PropTroniX/E-11-Blaster-Scope-Electronics-V1.0/README.md

------------

##### *Table of Contents*
- [Arduino E-11 Animated Blaster Scope](#arduino-e-11-animated-blaster-scope)
- [Video of the Prototype](#video-of-the-prototype)
- [Parts Required](#parts-required)
- [Software Required](#software-required)
- [Wiring Schematics](#wiring-schematics)
- [Programming Instructions](#programming-instructions)
- [3D Print STL Files](#3d-print-stl-files)
- [Licence](#licence)
- [Donation Button](#donation-button)

### Arduino E-11 Animated Blaster Scope

Arduino code and STL files for an animated Star Wars E-11 Blaster Scope with optional Red Dot Laser Sight. 
This is a very basic build just to add some functionality to your Star Wars Blaster Scope.
Easy to build with only minimal wiring required using cheap and readily available parts. 
The 3D STL files to print the E-11 Blaster Scope to fit these electronics are included in the Download.

If you looking for changeable Screen Displays on your Scope check out my - [E-11 V2.0 Scope Kit](https://proptronix.co.uk/prop-electronics/e-11-v2-scope-add-on-kit "PropTroniX")





### Video of the Prototype

Check out my Video of a 3D Printed Prototype with the Electronics Installed

YouTube Video - [Star Wars E-11 Blaster Scope with Electronics](https://youtu.be/OtV69T4YZjw "Star Wars E-11 Blaster Scope with Electronics")

###  Parts Required

1 x Set of 3D STLFiles  - For 3D Printing the E-11 Blaster Scope (Included FREE in the Download)

1 x [DFRobot Beetle] - ATmega32u4 V 16MHz Micro USB 

1 x [Red Laser Dot Diode] - 650nm 6mm 3V-5V (Optional)

1 x[ 0.49 OLED Display] - White OLED Screen Module SSD1306 Drive IC 64 x 32 IIC Interface

1 x [6mm Tactile Momentary Switch] - 2 Pin SPDT Momentary Tactile Pushbutton Switch 6mm x 6mm x 5mm (Optional)

1 x [10K Ω Resistor ]- 1/4W 5% Carbon Resistors - Used on the ON/Button for the Red Dot Laser

1 x [4-Pin Micro JST Cable] - (Male & female) For Connecting OLED Screen to DFRobot Beetle

1 x [3-Pin Micro JST Cable] - (Male & female) For Connecting Red Dot Laser Switch to DFRobot Beetle

2 x [2-Pin Micro JST Cable]( - (Male & female) For Connecting Red Dot Laser Diode to DFRobot Beetle & to supply 5V Power to the DFRobot Beetle

3 x [M2 Slotted Cheese Head Machine Screws] - For the Front of the Scope

2 x [4x3mm Neodymium Magnets]( - To Hold the Screen Holder in Place inside the Scope

1 x [30mm Round Glass Cabochon ]- Used as a Magnifier Lens for the Scope Eye Piece

All parts listed above are available from my Online Shop , eBay, Amazon or AliExpress.

###  Software Required

You will need the following Software & Libraries to install and setup the Scope Arduino Code on the DFRobot Beetle.
- The latest version of Arduino IDE - [Download from the Arduino Site](https://www.arduino.cc/en/Main/Software "Download from the Arduino Site")

Arduino Libraries Needed:

- WIRE - Pre-Installed with Arduino IDE
- SPI - Pre-Installed with Arduino IDE
- Adafruit GFX - Included in the Download
- Adafruit SSD1306 - Included in the download and Pre-Set for 64x32 OLED Display

SCTroniX V1.0 Arduino E-11 Scope Code:

- Arduino_Blaster_Scope-V1.0.ino - Included in the Download

###  Wiring Schematics



###  Programming Instructions

1. Copy the Two Included Libraries (Adafruit_GFX_Library & Adafruit_SSD1306-master_64x32) into your Arduino Libraries Folder.

2. Run the Arduino IDE Application

3. File Open and locate the Arduino-Blaster-Scope-V1.0 Directory and open the Load the Arduino_Blaster_Scope-V1.0.ino file.

4. Select Tools: Board: and Arduino Leonardo

5. Select Tools: Port: and Select the COM Port your DFRobot Beetle board is plugged in to.

6. Select Tools: Programmer: and choose AVRISP mkII.

7. Upload the Arduino_Blaster_Scope-V1.0.ino code to the board

You should now have a functioning Blaster Scope

### 3D Print STL Files
The download also includes a set of E-11 Blaster Scope 3D Printable STL Files. These are modified from the Free Files that are available from [My Mini Factory](https://www.myminifactory.com/object/3d-print-star-wars-storm-trooper-blastech-e-11-blaster-rifle-by-blaster-master-72283 "My Mini Factory") by Raymond Hebert.



###  Licence

This work is licensed under the Creative Commons Attribution-NonCommercial-ShareAlike 4.0 International License.
To view a copy of this license, visit https://creativecommons.org/licenses/by-nc/4.0/

### Donation Button
 Please feel free to donate a cup of coffee if you find this code useful. Thank You
