PropTroniX/E-11-Blaster-Scope-Electronics-V1.0/Scope-STL-Files/Part_#6_Scope_Lens Cap.stl

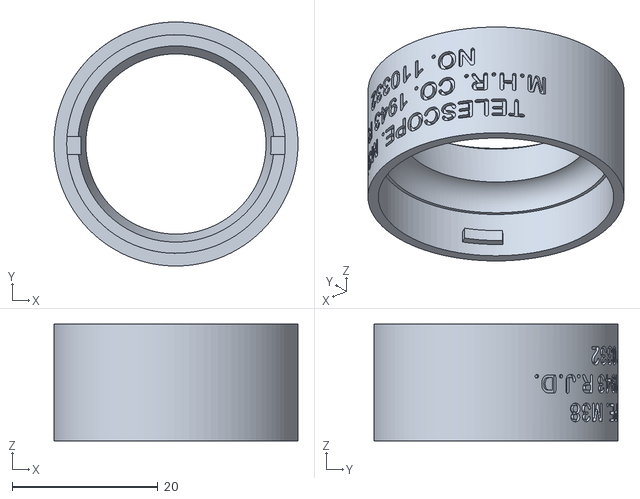
[picture p1: CAD file, 2023-04-13]
Scope-STL-Files/Part_#6_Scope_Lens Cap.stl
33.5 x 33.5 x 16.0
