PropTroniX/E-11-Blaster-Scope-Electronics-V1.0/Scope-STL-Files/Part_#3_Scope_Front_Body.stl

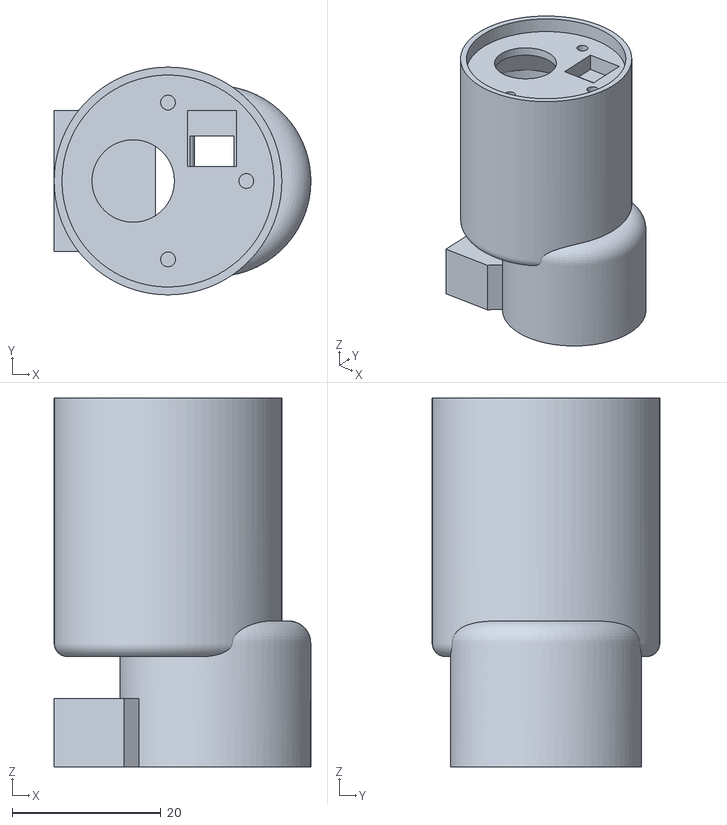
[picture p2: CAD file, 2023-04-13]
Scope-STL-Files/Part_#3_Scope_Front_Body.stl
34.5 x 30.6 x 49.6
