PropTroniX/E-11-Blaster-Scope-Electronics-V1.0/Scope-STL-Files/Part_#2_Scope_Front_End.stl

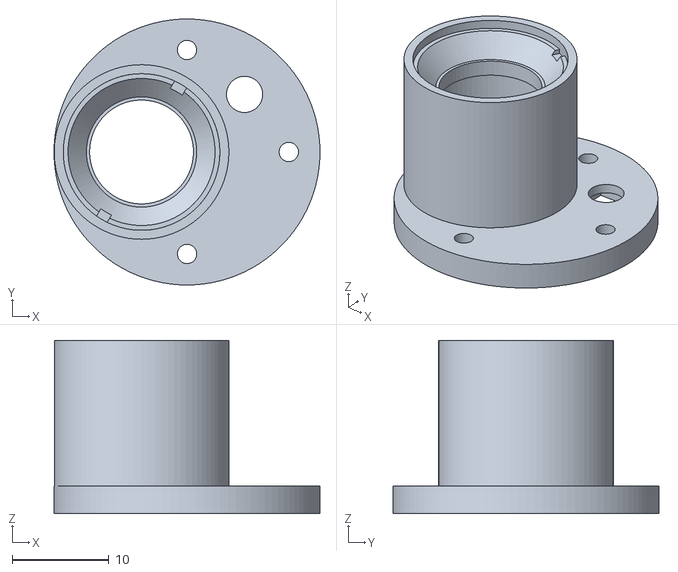
[picture p3: CAD file, 2023-04-13]
Scope-STL-Files/Part_#2_Scope_Front_End.stl
27.5 x 27.5 x 17.9
