PropTroniX/E-11-Blaster-Scope-Electronics-V1.0/Scope-STL-Files/Part_#5_Scope_Rear_Body.stl

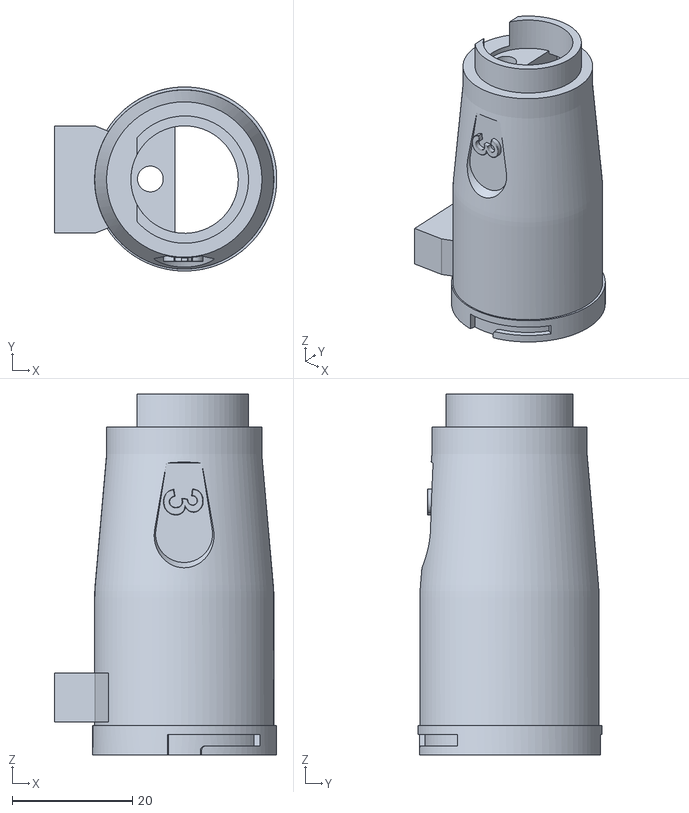
[picture p4: CAD file, 2023-04-13]
Scope-STL-Files/Part_#5_Scope_Rear_Body.stl
37.1 x 30.7 x 60.2
