PropTroniX/E-11-Blaster-Scope-Electronics-V1.0/Scope-STL-Files/Part_#4_Electronics_Holder.stl

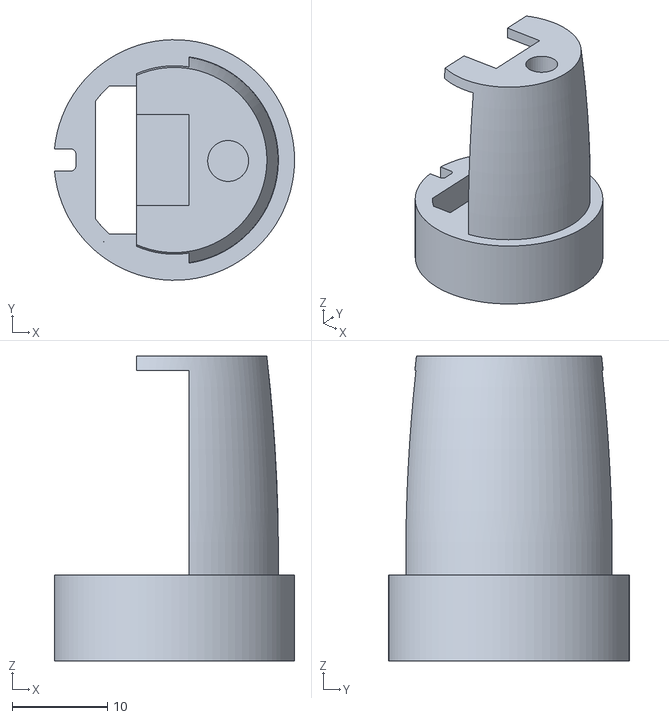
[picture p5: CAD file, 2023-04-13]
Scope-STL-Files/Part_#4_Electronics_Holder.stl
25.2 x 25.2 x 32.0
