PropTroniX/E-11-Blaster-Scope-Electronics-V1.0/Scope-STL-Files/Part_#1_Laser_LED_Holder.stl

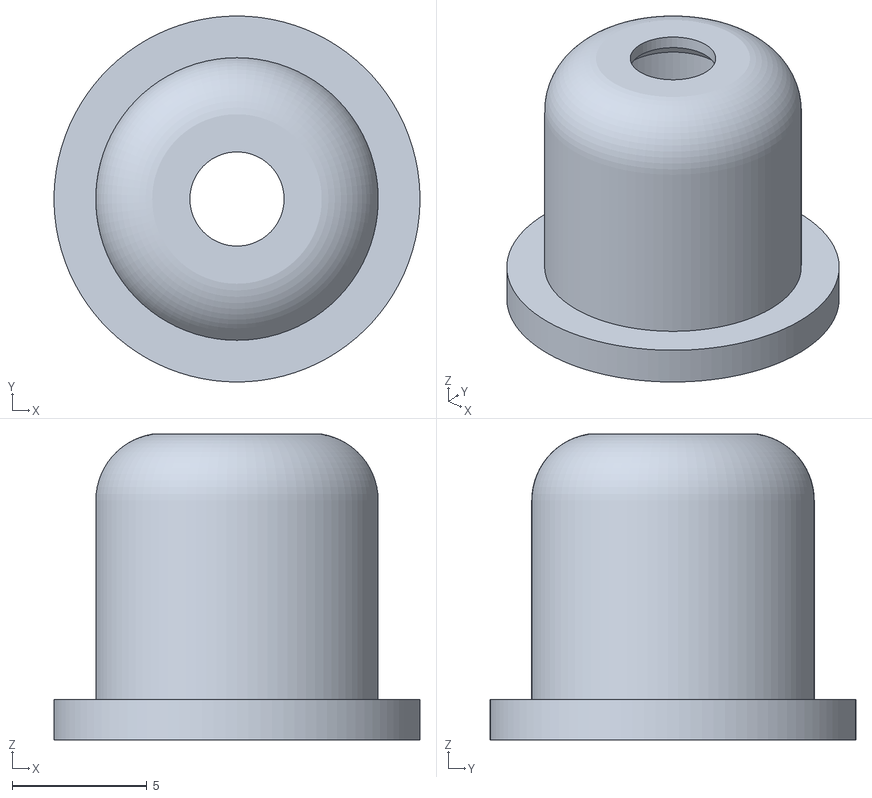
[picture p6: CAD file, 2023-04-13]
Scope-STL-Files/Part_#1_Laser_LED_Holder.stl
13.6 x 13.6 x 11.4
